igokraj/STM32_FreeRTOS_Industrial_Modbus_Node/Core/Src/main.c

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
/* Includes ------------------------------------------------------------------*/
#include "main.h"
#include "cmsis_os.h"
#include "dma.h"
#include "i2c.h"
#include "iwdg.h"
#include "tim.h"
#include "usart.h"
#include "gpio.h"

/* USER CODE BEGIN Includes */
#include "stdbool.h"
#include "crc.h"
#include "temp_sensor.h"
#include "reset_log.h"
#include "app_shared.h"
/* USER CODE END Includes */


/* USER CODE BEGIN PV */
// **** MODBUS ****

uint8_t modbus_rx_buffer[MODBUS_RX_BUFFER_SIZE]; // Buffer for the circular DMA
volatile uint16_t modbus_rx_len = 0; // Length of the frame, handled in callback (volatile)
volatile bool modbus_frame_ready = 0; // Status of the frame, handled in callback (volatile)
uint16_t modbus_rx_last_pos = 0; // DMA write position at the previous TIM1 tick
uint16_t holding_registers_map[REGISTER_COUNT] = {0}; // Register map
uint8_t modbus_tx_buffer[MODBUS_RX_BUFFER_SIZE]; // buffer for sending data

// **** SYSTEM STATUS **** 
volatile System_State_t system_state = STATE_INIT;

// **** BINARY SEMAPHORE ****
extern osSemaphoreId_t FrameReadySemaphoreHandle; // defined in freertos.c

// **** DIAGNOSTIC TASK **** 
volatile uint8_t task_alive_flags;
/* USER CODE END PV */

void SystemClock_Config(void);
void MX_FREERTOS_Init(void);
/**
  * @brief  The application entry point.
  * @retval int
  */
int main(void)
{

  /* USER CODE BEGIN 1 */
  ResetCause_t reset_cause = get_reset_cause();
  log_reset_cause_to_flash(reset_cause);
  /* USER CODE END 1 */

  /* MCU Configuration--------------------------------------------------------*/

  /* Reset of all peripherals, Initializes the Flash interface and the Systick. */
  HAL_Init();

  /* USER CODE BEGIN Init */
  __HAL_DBGMCU_FREEZE_IWDG();
  /* USER CODE END Init */

  /* Configure the system clock */
  SystemClock_Config();

  /* Initialize all configured peripherals */
  MX_GPIO_Init();
  MX_DMA_Init();
  MX_USART2_UART_Init();
  MX_I2C1_Init();
  MX_TIM1_Init();
  MX_IWDG_Init();
  /* USER CODE BEGIN 2 */
  holding_registers_map[3] = 0x0200;
  // Firmware version exposed over Modbus 

  HAL_TIM_Base_Start_IT(&htim1);
  // TIM1 period = 1.75 ms = fixed Modbus RTU t3.5 (inter-frame silence) value for baud rates > 19200 bps

  HAL_UART_Receive_DMA(&huart2, modbus_rx_buffer, MODBUS_RX_BUFFER_SIZE);
  // Start continuous circular DMA reception into modbus_rx_buffer (runs in the background, never stops)


  // Expose the cause of the reset that just happened as a Modbus register
  holding_registers_map[2] = read_last_reset_cause_from_flash();

  // Number of resets recorded in Flash since the last sector erase
  holding_registers_map[4] = get_reset_count();
  /* USER CODE END 2 */

  /* Init scheduler */
  osKernelInitialize();  /* Call init function for freertos objects (in cmsis_os2.c) */
  MX_FREERTOS_Init();

  /* Start scheduler */
  osKernelStart();

  /* We should never get here as control is now taken by the scheduler */

  /* Infinite loop */
  /* USER CODE BEGIN WHILE */
  
  while (1)
  {
 
    /* USER CODE END WHILE */

    /* USER CODE BEGIN 3 */
  }
  /* USER CODE END 3 */
}

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
/* USER CODE BEGIN 4 */




// Read the state of the cylinder
void HAL_GPIO_EXTI_Callback(uint16_t GPIO_Pin)
{
  if (GPIO_Pin == Cylinder_Limit_Switch_Pin_Pin) {
    holding_registers_map[1] = (HAL_GPIO_ReadPin(Cylinder_Limit_Switch_Pin_GPIO_Port, Cylinder_Limit_Switch_Pin_Pin) == GPIO_PIN_RESET);
  }
}
/* USER CODE END 4 */

/**
  * @brief  Period elapsed callback in non blocking mode
  * @note   This function is called  when TIM6 interrupt took place, inside
  * HAL_TIM_IRQHandler(). It makes a direct call to HAL_IncTick() to increment
  * a global variable "uwTick" used as application time base.
  * @param  htim : TIM handle
  * @retval None
  */
void HAL_TIM_PeriodElapsedCallback(TIM_HandleTypeDef *htim)
{
  if (htim->Instance == TIM6)
  {
    HAL_IncTick();
  }
  /* USER CODE BEGIN Callback 1 */

  // Fires every 1.75 ms (TIM1 overflow). Detects Modbus frame end by checking whether the DMA write position has stayed the same since the last tick.
 if (htim->Instance == TIM1) { 
  
    // current DMA write offset in the buffer (counts up as bytes arrive)
    uint16_t pos = MODBUS_RX_BUFFER_SIZE - __HAL_DMA_GET_COUNTER(huart2.hdmarx);

    // check if there are any new bytes since the last 1.75 ms tick
    if (pos != modbus_rx_last_pos) {
      modbus_rx_last_pos = pos;
    }
    // no new bytes for a full 1.75 ms tick -> silence detected, frame is complete
    else if (pos != 0 && !modbus_frame_ready) {
      modbus_rx_len = pos;
      modbus_frame_ready = true;
      osSemaphoreRelease(FrameReadySemaphoreHandle); // Wake up ModbusTask
    }
    }
  /* USER CODE END Callback 1 */
}

/**
  * @brief  This function is executed in case of error occurrence.
  * @retval None
  */
void Error_Handler(void)
{
  /* USER CODE BEGIN Error_Handler_Debug */
  /* User can add his own implementation to report the HAL error return state */
  __disable_irq();
  while (1)
  {
  }
  /* USER CODE END Error_Handler_Debug */
}
#ifdef USE_FULL_ASSERT
/**
  * @brief  Reports the name of the source file and the source line number
  *         where the assert_param error has occurred.
  * @param  file: pointer to the source file name
  * @param  line: assert_param error line source number
  * @retval None
  */
void assert_failed(uint8_t *file, uint32_t line)
{
  /* USER CODE BEGIN 6 */
  /* User can add his own implementation to report the file name and line number,
     ex: printf("Wrong parameters value: file %s on line %d\r\n", file, line) */
  /* USER CODE END 6 */
}
#endif /* USE_FULL_ASSERT */
