igokraj/STM32_FreeRTOS_Industrial_Modbus_Node/Core/Inc/main.h

#define Cylinder_Limit_Switch_Pin_Pin GPIO_PIN_13
#define Cylinder_Limit_Switch_Pin_GPIO_Port GPIOC
#define Cylinder_Limit_Switch_Pin_EXTI_IRQn EXTI15_10_IRQn
#define USART_TX_Pin GPIO_PIN_2
#define USART_TX_GPIO_Port GPIOA
#define USART_RX_Pin GPIO_PIN_3
#define USART_RX_GPIO_Port GPIOA
#define LED_Pin GPIO_PIN_5
#define LED_GPIO_Port GPIOA
#define TMS_Pin GPIO_PIN_13
#define TMS_GPIO_Port GPIOA
#define TCK_Pin GPIO_PIN_14
#define TCK_GPIO_Port GPIOA
#define SWO_Pin GPIO_PIN_3
#define SWO_GPIO_Port GPIOB
#define HTU21D_SCL_Pin GPIO_PIN_6
#define HTU21D_SCL_GPIO_Port GPIOB
#define HTU21D_SDA_Pin GPIO_PIN_7
#define HTU21D_SDA_GPIO_Port GPIOB
