igokraj/STM32_FreeRTOS_Industrial_Modbus_Node/(commit log)

2026-08-13 Quick UART test
2026-08-14 Added modbus frame detection with DMA + TIM1 silence detection, THIS IS A TEST
2026-08-16 Added py tool to test the modbus funcionality - it works correctly
    [main.c, test_read_register.py]
2026-08-16 Added files to handle I2C and HTU21D funcionality
2026-08-16 Added additional pull-ups for HTU21D (my sensor does not work without them)
    [STM32_Industrial_Modbus_Node.ioc, main.c]
2026-08-16 Refactor HTU21D I2C communication to handle transmission errors and update holding registers initialization
    [main.c, temp_sensor.c]
2026-08-16 Add switch for cylidner position status and interrupt handling
2026-08-16 Added state machine to the project and fixed problem with watchdog and .c files in CMake
    [STM32_Industrial_Modbus_Node.ioc, main.c, temp_sensor.c]
2026-08-16 Added reset cause logging functionality
    [main.c, reset_log.c, reset_log.h]
2026-08-16 Enhance Modbus functionality by exposing last reset cause and updating test script
    [main.c, test_read_register.py]
2026-08-16 Added command to freeze IWDG during debugging to prevent MCU resets
    [main.c]
2026-08-17 Added SensorTask -> Modbus is no longer blocked by I2C
    [main.c, temp_sensor.c, test_latency.py]
2026-08-17 Added binary Semephore to replace frame-ready pooling
    [STM32_Industrial_Modbus_Node.ioc, main.c]
2026-08-18 Added reset count funcionality
    [app_shared.h, main.c, reset_log.c, reset_log.h, test_read_register.py]
